tofergregg/smith_corona_printer/SmithCoronaBeanCUPS_Driver/BeanDemo/en.lproj/Credits.rtf

Engineering:
Chris Gregg, Kate Wasnyczuk, Derek Seabury

Special thanks:
Initial solenoid idea courtesy of Bruce Molay
