tofergregg/smith_corona_printer/SmithCoronaBeanCUPS_Driver/BeanDemoOSX.png

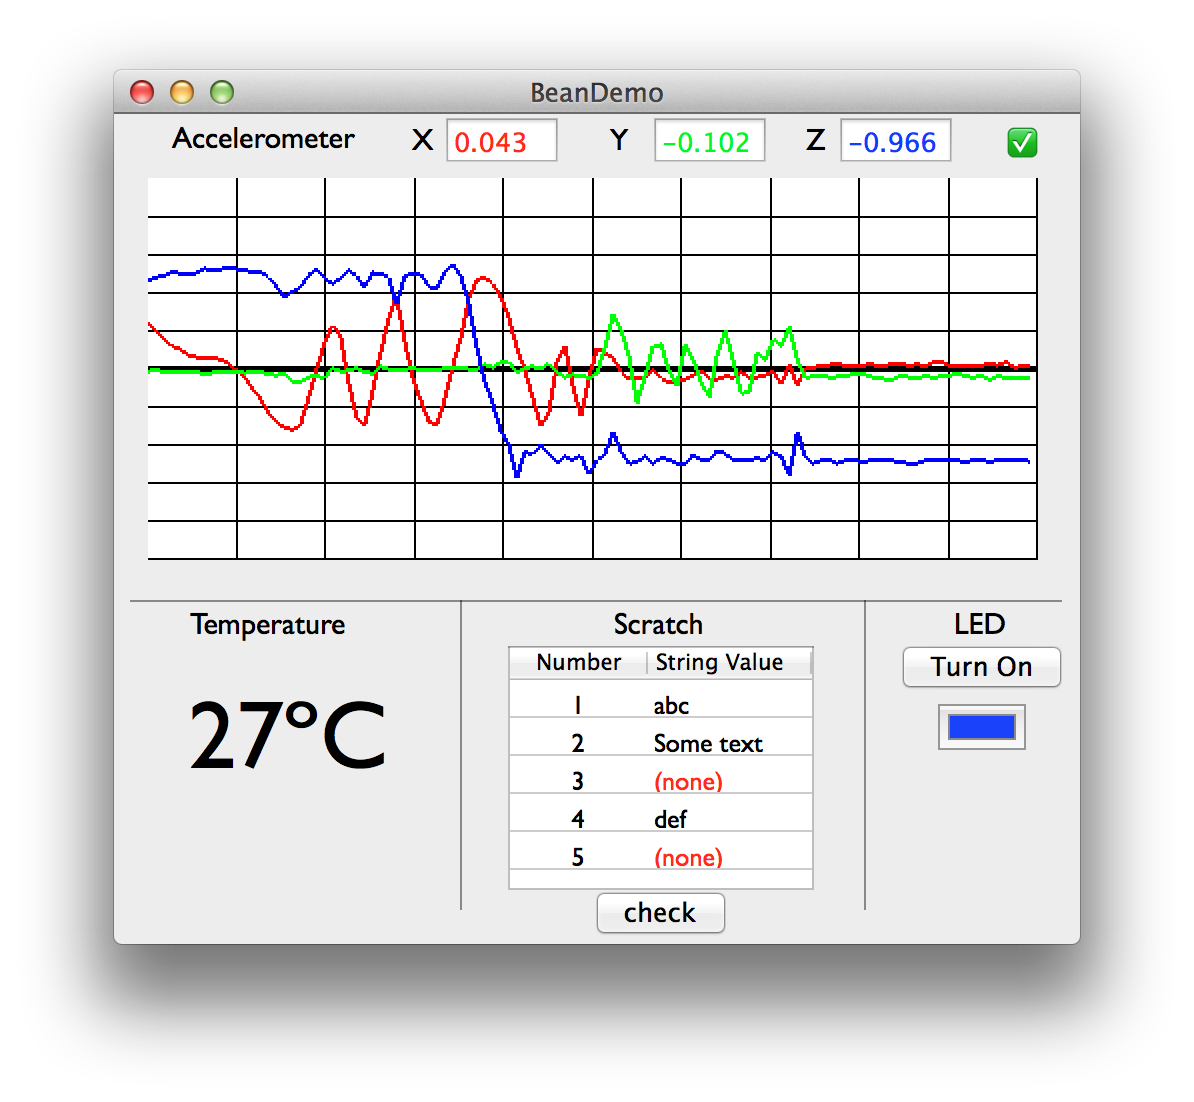
SmithCoronaBeanCUPS_Driver/BeanDemoOSX.png
