tofergregg/smith_corona_printer/TypewriterEaglePCB/typewriter_shift.brd

## EAGLE design TypewriterEaglePCB/typewriter_shift.brd (2015-05-11)

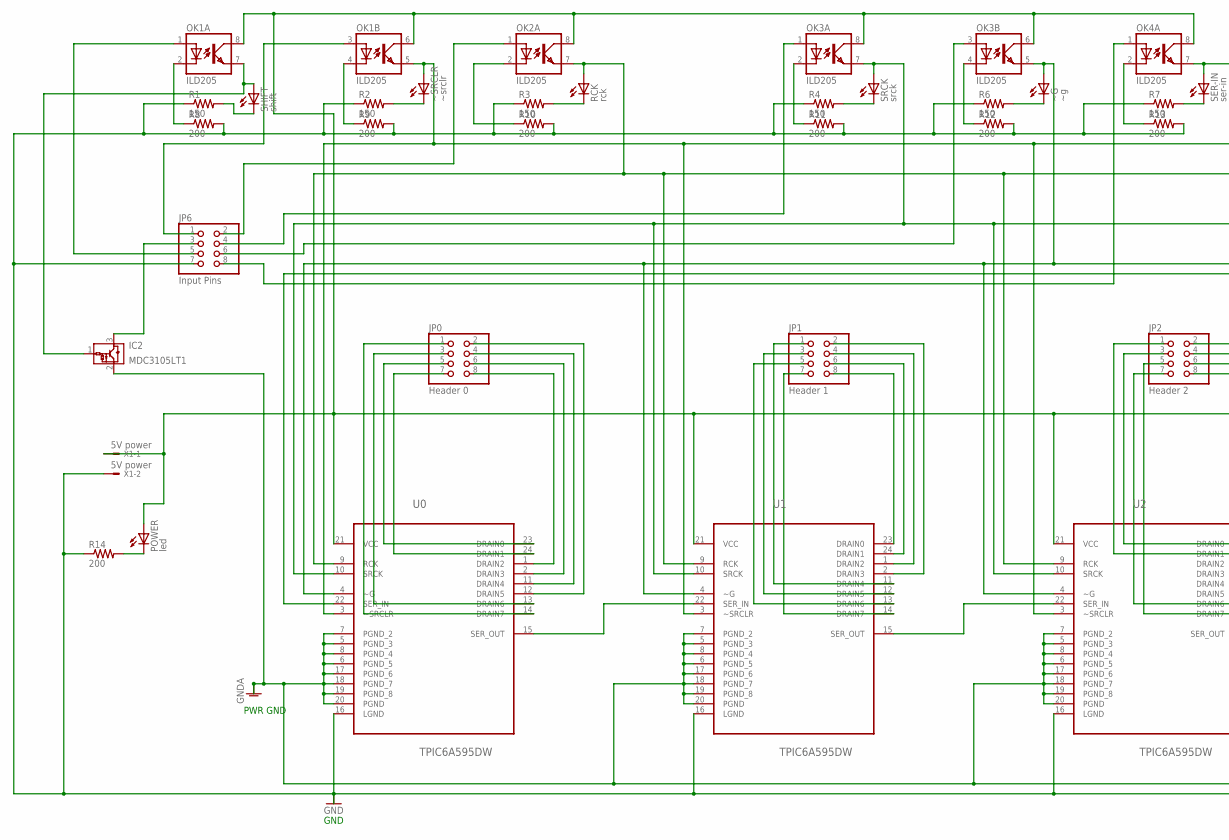
[picture p2: schematic typewriter_shift.sch, part in row 1, column 1]

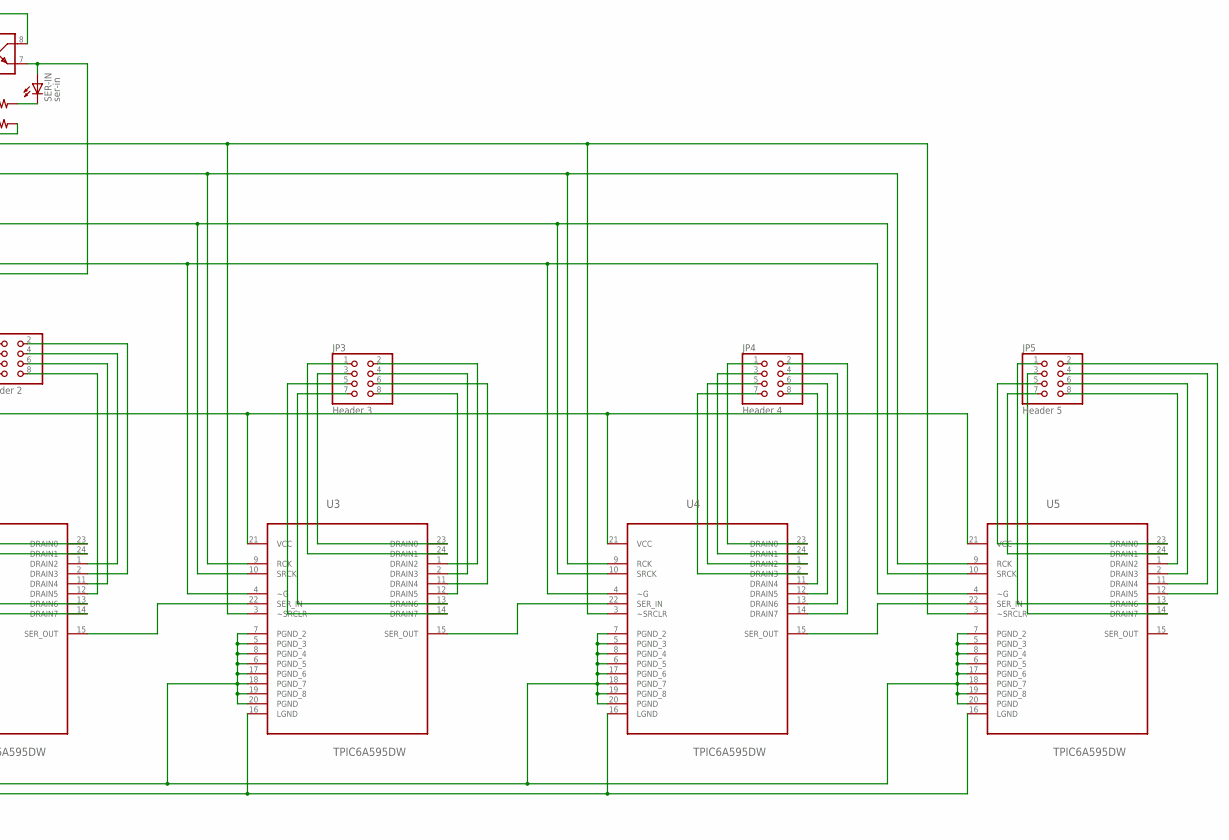
[picture p3: schematic typewriter_shift.sch, part in row 1, column 2]

Parts:
IC2: MDC3105LT1; SOT23
JP0: Header 0; 2X04/90
JP1: Header 1; 2X04/90
JP2: Header 2; 2X04/90
JP3: Header 3; 2X04/90
JP4: Header 4; 2X04/90
JP5: Header 5; 2X04/90
JP6: Input Pins; 2X04/90
OK1, OK2, OK3, OK4: ILD205; SOIC08
POWER: led; SML1206
R1, R2, R3, R4, R6, R7: 150; R1206
R8, R9, R10, R11, R12, R13, R14: 200; R1206
RCK: rck; SML1206
SER-IN: ser-in; SML1206
SHIFT: shift; SML1206
SRCK: srck; SML1206
U0, U1, U2, U3, U4, U5: TPIC6A595DW; SOIC127P1030X265-24N
X1: 5V power; KK-156-2
~G: ~g; SML1206
~SRCLR: ~srclr; SML1206

Connections:
GND: JP6.7, R1.1, R2.1, R3.1, R4.1, R6.1, R7.1, R8.2, R9.2, R10.2, R11.2, R12.2, R13.2, R14.1, U0.16 (LGND), U1.16 (LGND), U2.16 (LGND), U3.16 (LGND), U4.16 (LGND), U5.16 (LGND), X1.2
GNDA: IC2.2 (GND), U0.5 (PGND_3), U0.6 (PGND_5), U0.7 (PGND_2), U0.8 (PGND_4), U0.17 (PGND_6), U0.18 (PGND_7), U0.19 (PGND_8), U0.20 (PGND), U1.5 (PGND_3), U1.6 (PGND_5), U1.7 (PGND_2), U1.8 (PGND_4), U1.17 (PGND_6), U1.18 (PGND_7), U1.19 (PGND_8), U1.20 (PGND), U2.5 (PGND_3), U2.6 (PGND_5), U2.7 (PGND_2), U2.8 (PGND_4), U2.17 (PGND_6), U2.18 (PGND_7), U2.19 (PGND_8), U2.20 (PGND), U3.5 (PGND_3), U3.6 (PGND_5), U3.7 (PGND_2), U3.8 (PGND_4), U3.17 (PGND_6), U3.18 (PGND_7), U3.19 (PGND_8), U3.20 (PGND), U4.5 (PGND_3), U4.6 (PGND_5), U4.7 (PGND_2), U4.8 (PGND_4), U4.17 (PGND_6), U4.18 (PGND_7), U4.19 (PGND_8), U4.20 (PGND), U5.5 (PGND_3), U5.6 (PGND_5), U5.7 (PGND_2), U5.8 (PGND_4), U5.17 (PGND_6), U5.18 (PGND_7), U5.19 (PGND_8), U5.20 (PGND)
unnamed: U0.15 (SER_OUT), U1.22 (SER_IN)
unnamed: U1.15 (SER_OUT), U2.22 (SER_IN)
unnamed: U2.15 (SER_OUT), U3.22 (SER_IN)
unnamed: U3.15 (SER_OUT), U4.22 (SER_IN)
unnamed: U4.15 (SER_OUT), U5.22 (SER_IN)
unnamed: R3.2, RCK.C
unnamed: OK4.7 (EMIT), SER-IN.A, U0.22 (SER_IN)
unnamed: R2.2, ~SRCLR.C
unnamed: JP0.7, U0.24 (DRAIN1)
unnamed: JP6.5, OK1.1 (A)
unnamed: JP0.5, U0.23 (DRAIN0)
unnamed: JP0.8, U0.1 (DRAIN2)
unnamed: JP0.6, U0.2 (DRAIN3)
unnamed: IC2.3 (VOUT), JP6.3
unnamed: IC2.1 (VIN), OK1.7 (EMIT), SHIFT.A
unnamed: OK1.2 (C), R8.1
unnamed: JP0.4, U0.11 (DRAIN4)
unnamed: JP0.2, U0.12 (DRAIN5)
unnamed: JP6.1, OK1.3 (A)
unnamed: JP0.3, U0.13 (DRAIN6)
unnamed: JP0.1, U0.14 (DRAIN7)
unnamed: JP6.2, OK2.1 (A)
unnamed: JP1.4, U1.1 (DRAIN2)
unnamed: JP1.6, U1.24 (DRAIN1)
unnamed: JP1.8, U1.23 (DRAIN0)
unnamed: JP1.2, U1.2 (DRAIN3)
unnamed: JP1.1, U1.11 (DRAIN4)
unnamed: JP6.4, OK3.1 (A)
unnamed: JP6.8, OK4.1 (A)
unnamed: JP6.6, OK3.3 (A)
unnamed: OK3.4 (C), R12.1
unnamed: JP1.7, U1.14 (DRAIN7)
unnamed: JP1.3, U1.12 (DRAIN5)
unnamed: JP1.5, U1.13 (DRAIN6)
unnamed: JP3.3, U3.23 (DRAIN0)
unnamed: JP2.6, U2.11 (DRAIN4)
unnamed: JP2.4, U2.1 (DRAIN2)
unnamed: JP2.2, U2.2 (DRAIN3)
unnamed: JP2.5, U2.14 (DRAIN7)
unnamed: JP2.7, U2.13 (DRAIN6)
unnamed: JP2.3, U2.23 (DRAIN0)
unnamed: JP2.1, U2.24 (DRAIN1)
unnamed: JP2.8, U2.12 (DRAIN5)
unnamed: JP3.1, U3.24 (DRAIN1)
unnamed: JP3.2, U3.1 (DRAIN2)
unnamed: JP3.4, U3.2 (DRAIN3)
unnamed: JP3.6, U3.11 (DRAIN4)
unnamed: JP3.8, U3.12 (DRAIN5)
unnamed: JP3.7, U3.13 (DRAIN6)
unnamed: JP3.5, U3.14 (DRAIN7)
unnamed: JP4.1, U4.23 (DRAIN0)
unnamed: JP4.3, U4.24 (DRAIN1)
unnamed: JP4.5, U4.1 (DRAIN2)
unnamed: JP4.7, U4.2 (DRAIN3)
unnamed: JP4.8, U4.11 (DRAIN4)
unnamed: JP4.6, U4.12 (DRAIN5)
unnamed: JP4.4, U4.13 (DRAIN6)
unnamed: JP4.2, U4.14 (DRAIN7)
unnamed: JP5.5, U5.23 (DRAIN0)
unnamed: JP5.7, U5.24 (DRAIN1)
unnamed: JP5.8, U5.1 (DRAIN2)
unnamed: JP5.6, U5.2 (DRAIN3)
unnamed: JP5.4, U5.11 (DRAIN4)
unnamed: JP5.2, U5.12 (DRAIN5)
unnamed: JP5.1, U5.13 (DRAIN6)
unnamed: JP5.3, U5.14 (DRAIN7)
unnamed: OK3.5 (EMIT), U0.4 (~G), U1.4 (~G), U2.4 (~G), U3.4 (~G), U4.4 (~G), U5.4 (~G), ~G.A
unnamed: OK3.7 (EMIT), SRCK.A, U0.10 (SRCK), U1.10 (SRCK), U2.10 (SRCK), U3.10 (SRCK), U4.10 (SRCK), U5.10 (SRCK)
unnamed: OK2.7 (EMIT), RCK.A, U0.9 (RCK), U1.9 (RCK), U2.9 (RCK), U3.9 (RCK), U4.9 (RCK), U5.9 (RCK)
unnamed: OK1.5 (EMIT), U0.3 (~SRCLR), U1.3 (~SRCLR), U2.3 (~SRCLR), U3.3 (~SRCLR), U4.3 (~SRCLR), U5.3 (~SRCLR), ~SRCLR.A
unnamed: OK4.2 (C), R13.1
unnamed: R1.2, SHIFT.C
unnamed: R4.2, SRCK.C
unnamed: R6.2, ~G.C
unnamed: OK3.2 (C), R11.1
unnamed: OK2.2 (C), R10.1
unnamed: OK1.4 (C), R9.1
unnamed: R7.2, SER-IN.C
unnamed: POWER.C, R14.2
VCC: OK1.6 (COL), OK1.8 (COL), OK2.8 (COL), OK3.6 (COL), OK3.8 (COL), OK4.8 (COL), POWER.A, U0.21 (VCC), U1.21 (VCC), U2.21 (VCC), U3.21 (VCC), U4.21 (VCC), U5.21 (VCC), X1.1

Notes on the sheet:
GND
PWR GND

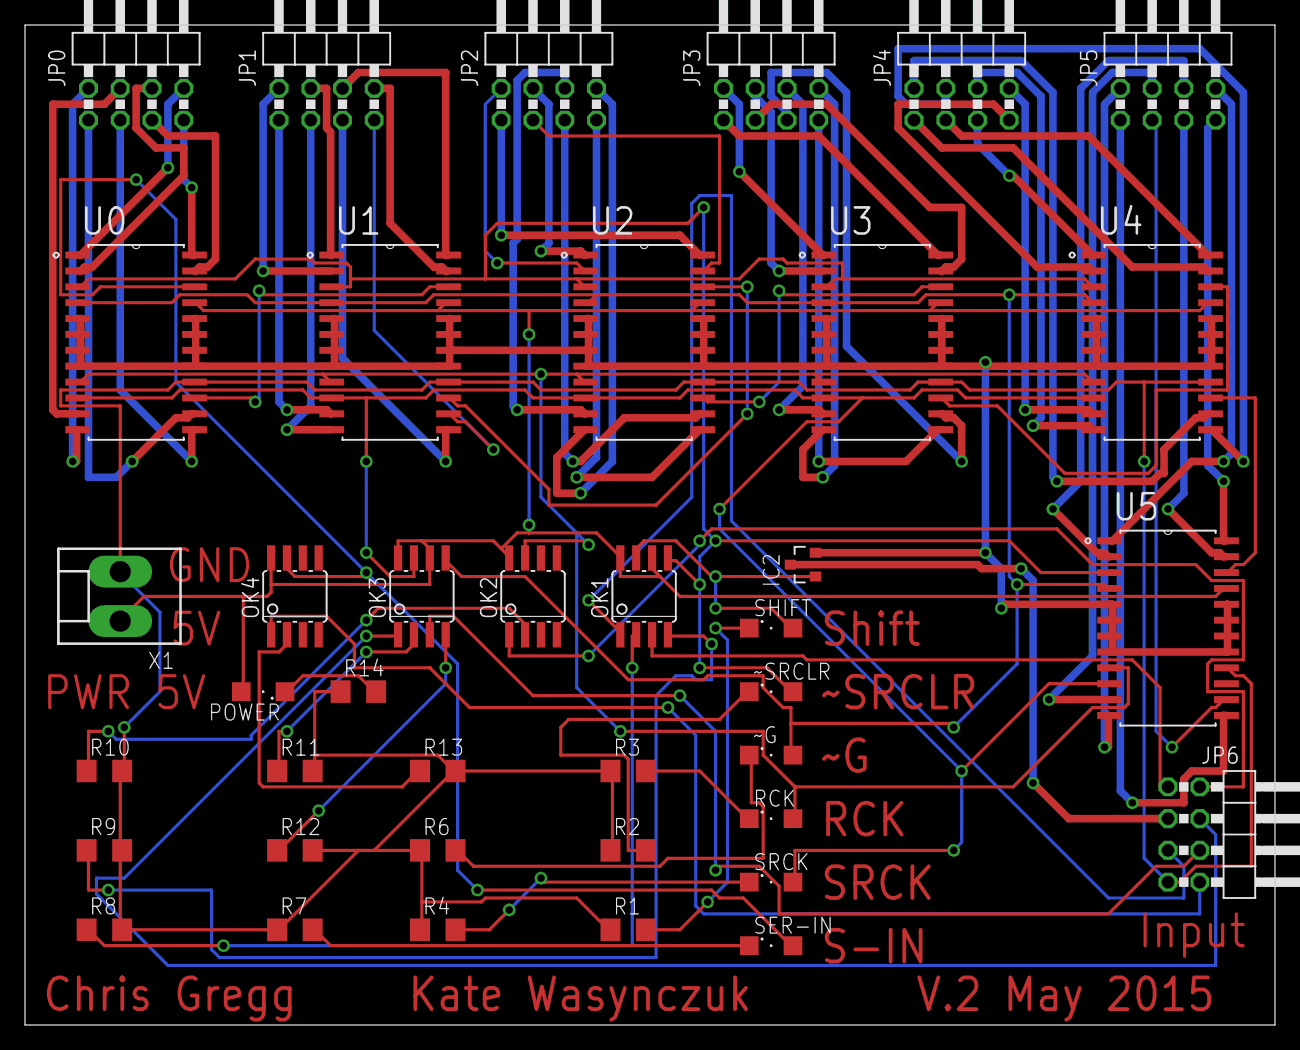
[picture p4: board typewriter_shift.brd from above]

Board: 2 copper layers, 100.0 x 80.0 mm, 39 parts (0 on the bottom side), 82 nets.
