tofergregg/smith_corona_printer/TypewriterBeanArduino/TypewriterBeanArduino.ino

// define BEAN for lightblue bean, UNO for UNO
#define UNO

#ifdef BEAN
// pin definitions (RCK is A0, which is defined in Bean Loader App pins_arduino.h)
#define _SRCLR	3
#define RCK 	18
#define SRCK 	2
#define _G 	5
#define SER_IN 	4
#define SHIFT 	1
#define LED	10

#else
// UNO pin definitions
#define _SRCLR	12
#define RCK 	11
#define SRCK 	10
#define _G 	8
#define SER_IN 	9
#define SHIFT 	13
#define LED	13
#endif

// letter definitions

#define _5	0
#define _9	1
#define _7	2
#define _6	3
#define _3	4
#define _4	5
#define _8	6
#define _2	7

#define _apost	8
#define _l	9
#define _j	10
#define _semic	11
#define _h	12
#define _n	13 
#define _return	14
#define _k	15

#define _u	16
#define _period	17
#define _b	18 
#define _space	19 
#define _shift  20
#define _m	21 
#define _slash	22
#define _comma	23

#define _s	24
#define _g	25 
#define _v	26 
#define _z	27 
#define _c	28
#define _d	29 
#define _f	30
#define _x	31

#define _bell   32
#define _backsp	33
#define _o	34
#define _i	35
#define _half	36
#define _0	37
#define _p	38
#define _dash   39

#define _q	40
#define _r	41
#define _y	42
#define _e	43
#define _a	44 
#define _w	45
#define _caps   46
#define _t	47

#define _excl	48 

#define _cent	1

#define _quart	1

void clearAll();

byte inbyte = 0;
boolean active = false;
int pinSet = -1;
int pinValue = 0;
int shiftAmt = 0;
int shifted = 0; // boolean
int special = 0; // boolean
int extraTime = 0; // boolean
int capslock = 0; // boolean

int beginRange,endRange;
int rangeCount = 0; // no range needed

int delayTime = 30;

void setup() {
  Serial.begin(57600); //open the serial port

  // set all pins to out
  #ifdef BEAN
  for (int i=0;i<6;i++) {
    pinMode(i,OUTPUT);
  }
  pinMode(A0,OUTPUT);
  pinMode(A1,OUTPUT);
  #else
  for (int i=8;i<=13;i++) {
    pinMode(i,OUTPUT);
  }
  pinMode(7,OUTPUT);
  pinMode(LED,OUTPUT);
  #endif
  
  // reset the shift registers (twice, for good measure)
  clearAll();
  clearAll();
  
  // set _SRCLR and _G high
  digitalWrite(_SRCLR,1);
  digitalWrite(_G,1);

  // set RCK,SRCK,SER-IN,SHIFT low
  digitalWrite(RCK,0);
  digitalWrite(SRCK,0);
  digitalWrite(SER_IN,0);
  digitalWrite(SHIFT,0);
  
  digitalWrite(A1,0);
  
}
void writeWithDelay(int pin,int value) {
  digitalWrite(pin,value);
  //delay(2);
}

void clearAll() {
    writeWithDelay(_SRCLR,0); // SRCLR low
    writeWithDelay(_SRCLR,1); // SRCLR high
    writeWithDelay(RCK,1); // RCK high
    writeWithDelay(RCK,0); // RCK low
}

void shiftBit() {
    writeWithDelay(SRCK,1); // SRCK high
    writeWithDelay(SRCK,0); // SRCK low
    writeWithDelay(RCK,1); // RCK high
    writeWithDelay(RCK,0); // RCK low
}

void setSerIn(int value) {
  if (value==0) {
    writeWithDelay(SER_IN,0);
  }
  else {
    writeWithDelay(SER_IN,1);
  }
}

void setBit(int bit) {    
    // first clear
    clearAll();
    
    // shift a 1
    setSerIn(1); // SER IN high
    shiftBit();
    
    // shift bit number of 0s
    setSerIn(0); // SER IN low

    for (int i=0;i<bit;i++) {
	shiftBit(); 
    }
}

void shiftKeyOn(){
  delay(5); // wait for mechanical movement
}

void shiftKeyOff(){
}

void keystroke() {
	// set _G low
	writeWithDelay(_G,0);

	// delay to allow strike
	delay(50);

	// set _G high
	writeWithDelay(_G,1);

        // delay for actual keystroke time
        delay(50);
        
        // clear the shift register
        clearAll();
}

void sendBackspace() {
        setBit(_backsp);
        
	// set _G low
	writeWithDelay(_G,0);

	// delay to allow strike
	delay(100);

	// set _G high
	writeWithDelay(_G,1);

        // delay for actual keystroke time
        delay(50);
	
}


void printNumWithColonSpace(int num) {
        // prints a number then a colon, then a space
        // e.g.: "12: "
        char strBuf[10];
        char *strToPrint=strBuf;
        shiftAmt = 0;
        itoa(num,strToPrint,10);

        while (*strToPrint != '\0') {
            Serial.write(*strToPrint);
            switch(*strToPrint) {
              case '0' :
                 shiftAmt = _0;
                 break;
              case '1' :
                 shiftAmt = _l;
                 break;
              case '2' :
                 shiftAmt = _2;
                 break;
              case '3' :
                 shiftAmt = _3;
                 break;
              case '4' :
                 shiftAmt = _4;
                 break;
              case '5' :
                 shiftAmt = _5;
                 break;
              case '6' :
                 shiftAmt = _6;
                 break;
              case '7' :
                 shiftAmt = _7;
                 break;
              case '8' :
                 shiftAmt = _8;
                 break;
              case '9' :
                 shiftAmt = _9;
                 break;
            }
            // print the character
            setBit(shiftAmt);
            keystroke();
            strToPrint++;    
        }
        // print a colon
        setBit(_semic);
        keystroke();
        
        // print a space
        setBit(_space);
        keystroke();
}

void printSpaces(int num) {
    setBit(_space);
    while (num-- > 0) {
      keystroke();
      delay(100);
    }
}

void capsOn() {
    setBit(_caps);
    // need slightly longer keystroke than the normal one
    // set _G low
    writeWithDelay(_G,0);

    // delay to allow strike
    delay(100);

    // set _G high
    writeWithDelay(_G,1);

    delay(100);
    capslock = 1;
}

void capsOff() {
    setBit(_shift);
    keystroke();
    delay(50);
    capslock = 0;
}

void loop() {
  shifted = 0; // start with no shift
  special = 0; // not a special value (e.g., set _G, etc.)
  shiftAmt = 0;
  extraTime = 0;
  inbyte = Serial.read(); //Read one byte (one character) from serial port.
  if (inbyte != 255) {
    //Serial.write(inbyte);
    Serial.write("{");

    // handle the case where we are looking for a range
    if (rangeCount == 1) {
        // this is beginRange
        beginRange = inbyte;
        rangeCount++;
        return;
    }
    else if (rangeCount == 2) {
        // this is the endRange
        endRange = inbyte;
        rangeCount = 0; // reset
        // now print the range
        for (int i=beginRange;i<=endRange;i++) {
            // print a return every 10 numbers
            if ((i-beginRange) % 5 == 0) {
              //setBit(_return);
              //keystroke();
              //delay(200); // delay for return
            }
            //printNumWithColonSpace(i);
            
            // print the character associated with the number
            setBit(i);
            keystroke();
            
            // print a return
            //printSpaces(5);
            delay(100); // wait a bit of time
        }
        // print one more return
        //setBit(_return);
        //keystroke();
        return;
    }
    
    // not waiting for range

    if (inbyte >= 'A' && inbyte <= 'Z') {
	shifted = 1;
	inbyte+=32; // converts to lowercase
    }

    // don't forget to handle exclamation point as special case
    switch (inbyte) {
  	case 'a':
		shiftAmt = _a;
		break;
	case 'b':
		shiftAmt = _b;
		break;
	case 'c':
		shiftAmt = _c;
		break;
	case 'd':
		shiftAmt = _d;
		break;
	case 'e':
		shiftAmt = _e;
		break;
	case 'f':
		shiftAmt = _f;
		break;
	case 'g':
		shiftAmt = _g;
		break;
	case 'h':
		shiftAmt = _h;
		break;
	case 'i':
		shiftAmt = _i;
		break;
	case 'j':
		shiftAmt = _j;
		break;
	case 'k':
		shiftAmt = _k;
		break;
	case 'l':
		shiftAmt = _l;
		break;
	case 'm':
		shiftAmt = _m;
		break;
	case 'n':
		shiftAmt = _n;
		break;
	case 'o':
		shiftAmt = _o;
		break;
	case 'p':
		shiftAmt = _p;
		break;
	case 'q':
		shiftAmt = _q;
		break;
	case 'r':
		shiftAmt = _r;
		break;
	case 's':
		shiftAmt = _s;
		break;
	case 't':
		shiftAmt = _t;
		break;
	case 'u':
		shiftAmt = _u;
		break;
	case 'v':
		shiftAmt = _v;
		break;
	case 'w':
		shiftAmt = _w;
		break;
	case 'x':
		shiftAmt = _x;
		break;
	case 'y':
		shiftAmt = _y;
		break;
	case 'z':
		shiftAmt = _z;
		break;
        case '1':
		shiftAmt = _l; // lowercase L
		break;
	case '2':
		shiftAmt = _2;
		break;
	case '3':
		shiftAmt = _3;
		break;
	case '4':
		shiftAmt = _4;
		break;
	case '5':
		shiftAmt = _5;
		break;
	case '6':
		shiftAmt = _6;
		break;
	case '7':
		shiftAmt = _7;
		break;
	case '8':
		shiftAmt = _8;
		break;
	case '9':
		shiftAmt = _9;
		break;
        case '0':
		shiftAmt = _0;
		break;
	case '@':
		shiftAmt = _2;
		shifted = 1;
		break;
	case '#':
		shiftAmt = _3;
		shifted = 1;
		break;
	case '$':
		shiftAmt = _4;
		shifted = 1;
		break;
	case '%':
		shiftAmt = _5;
		shifted = 1;
		break;
	case '&':
		shiftAmt = _7;
		shifted = 1;
		break;
	case '*':
		shiftAmt = _8;
		shifted = 1;
		break;
	case '(':
		shiftAmt = _9;
		shifted = 1;
		break;
	case ')':
		shiftAmt = _0;
		shifted = 1;
		break;
	case '-':
		shiftAmt = _dash;
		break;
	case '_':
		shiftAmt = _dash;
		shifted = 1;
		break;
	case ';':
		shiftAmt = _semic;
		break;
	case ':':
		shiftAmt = _semic;
		shifted = 1;
		break;
	case '\'':
  		shiftAmt = _apost;
		break;
	case '"':
		shiftAmt = _apost;
		shifted = 1;
		break;
	case ',':
		shiftAmt = _comma;
		break;
	case '.':
		shiftAmt = _period;
		break;
	case '/':
		shiftAmt = _slash;
		break;
	case '?':
		shiftAmt = _slash;
		shifted = 1;
		break;
	case ' ':
		shiftAmt = _space;
		break;
	case '\n':
		shiftAmt = _return;
                extraTime = 1;
		break;
        
        case '|':
                shiftAmt = _bell;
                break;

	case 127: // backspace
		shiftAmt = _backsp;
		break;
	case 'a'+127:
		special = 1;
		pinSet = _SRCLR;
    		pinValue = 1;
                break;
    	case 'b'+127:
		special = 1;
		pinSet = _SRCLR;
    		pinValue = 0;
                break;
    	case 'c'+127:
		special = 1;
		pinSet = _G;
    		pinValue = 1;
                break;
    	case 'd'+127:
		special = 1;
		pinSet = _G;
    		pinValue = 0;
                break;
    	case 'e'+127:
		special = 1;
		pinSet = RCK;
    		pinValue = 1;
                break;
    	case 'f'+127:
		special = 1;
		pinSet = RCK;
    		pinValue = 0;
                break;
    	case 'g'+127:
		special = 1;
		pinSet = SRCK;
    		pinValue = 1;
                break;
    	case 'h'+127:
		special = 1;
		pinSet = SRCK;
    		pinValue = 0;
                break;
    	case 'i'+127:
		special = 1;
		pinSet = SER_IN;
    		pinValue = 1;
                break;
    	case 'j'+127:
		special = 1;
		pinSet = SER_IN;
    		pinValue = 0;
                break;
    	case 'k'+127:
		special = 1;
		pinSet = SHIFT;
    		pinValue = 0;
                break;
    	case 'l'+127:
		special = 1;
		pinSet = SHIFT;
    		pinValue = 1;
                break;
    	case 'm'+127:
		special = 1;
		pinSet = LED;
    		pinValue = 1;
                break;
    	case 'n'+127:
		special = 1;
		pinSet = LED;
    		pinValue = 0;
                break;
        case 'o'+127: // range to print
                special = 1;
                rangeCount = 1;
                break;
        default:
                special = 1;
                pinSet = -1;
                pinValue = 1;
                Serial.write("}");
                Serial.write(inbyte);
      }

    if (special == 1) {
      if (rangeCount == 1) return; // range will follow
      if (pinSet == LED) {
    	  if (pinValue == 0) {
                #ifdef BEAN
    	  	Bean.setLed(0,0,0);
                #else
                digitalWrite(LED,0);
                #endif
                
    	  }
    	  else {
                #ifdef BEAN
    	  	Bean.setLed(255,0,0); // red
                #else
                digitalWrite(LED,1);
                #endif
    	  }
      }
      else if (inbyte == '!') {
        // special case, have to send apostrophe, backspace, period
        clearAll();
        
        if (capslock) {
            capsOff();
        }
        setBit(_apost);
        keystroke();
        
        delay(100);
        sendBackspace();
        delay(100);
        
        setBit(_period);
        keystroke();
        return;
      }
      else if (inbyte == 127) {
          // backspace
          sendBackspace();
      }
      else if (pinSet == -1) {
         // default
      }
      else {
      	writeWithDelay(pinSet,pinValue);
        delay(20); // time to take
      	Serial.write('^'); // no caret character, so just send back as special
      }
    }
    else { // regular character
    	// first, clear shift registers
    	clearAll();
  	
  	if (shifted && !capslock) {
		// turn on caps
                capsOn();
	}
        else if (!shifted && capslock) {
                // turn off caps
                capsOff();
        }
                
	setBit(shiftAmt); // set bit based on shift amount
	keystroke(); // go!

        if (extraTime) {
          delay(500);
        }
	
	// send character back for debugging purposes
	Serial.write(inbyte);
        Serial.write("]"); // other special character
    }
  }
  #ifdef BEAN
  Bean.sleep(50);
  #else
  delay(delayTime);
  #endif
}
