tofergregg/smith_corona_printer/(commit log)

2015-05-10 updated name for PCB directory
    [typewriter_shift.brd, typewriter_shift.sch]
2015-05-10 had to rename arduino file so it matched the folder name...
2015-05-10 Fixed spelling mistake on folder name
    [SerialBeanArduino.ino]
2015-05-10 Updated eagle files
    [typewriter_shift.brd]
2015-05-10 Updated directory to match style
    [typewriter_shift.brd, typewriter_shift.sch]
2015-05-11 latest update with resistors and LEDs
2015-05-11 Updated circuit with correct resistances for optoisolators and LEDs
    [typewriter_shift.brd, typewriter_shift.sch]
2015-05-11 Added wide power ground traces and 1206 resistors
    [typewriter_shift.brd, typewriter_shift.sch]
2015-05-23 Added shift code to Arduino
2015-05-24 Revamped Arduino code to send actual characters
2015-05-24 Added most character codes to Arduino.
2015-05-24 Updated inital character mappings on Arduino
2015-05-28 Initial CUPS printer driver commit
2015-05-30 Added capslock and shift to Arduino; fixed up lots of little errors. Also added exclamation point, which is an apostrophe-backspace-period
    [TypewriterBeanArduino.ino]
2015-05-31 removed some old driver info
2015-05-31 renamed driver with CUPS identifier
2015-06-01 Initial commit for Bean CUPS driver
2015-06-02 updated CUPS driver to handle then not handle being a printer driver. Can't figure out how to get the driver to run as a standalone program, nor how to actually use the windows (e.g., you can't type 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
2015-06-02 updated original driver with smithcorona names
2015-06-02 After breaking the circuit and fixing it with new chips, we are back to a regular layout for the keys - e.g., no more jumping a spot due to a wonky first or second shift register.
    [TypewriterBeanArduino.ino]
2015-06-21 Added Arduino Serial port files
2015-06-25 Added Lasercutter template and MIDI files
2015-06-25 Updated keyboard template for second shift key hole
2015-06-30 Updated Arduino code for bell
2015-07-01 Added a MIDI file with the bell and Carriage Return tracks in the Flute track
2015-07-21 Added new Arduino MIDI sketch
2015-07-21 Updated original MIDI arduino sketch
2017-01-02 updated actualTypewriter.py to find correct MIDI
    [TypewriterSongMIDI2.ino]
